SwiftyTheFox001/RelayClock/relayclock_digits.png

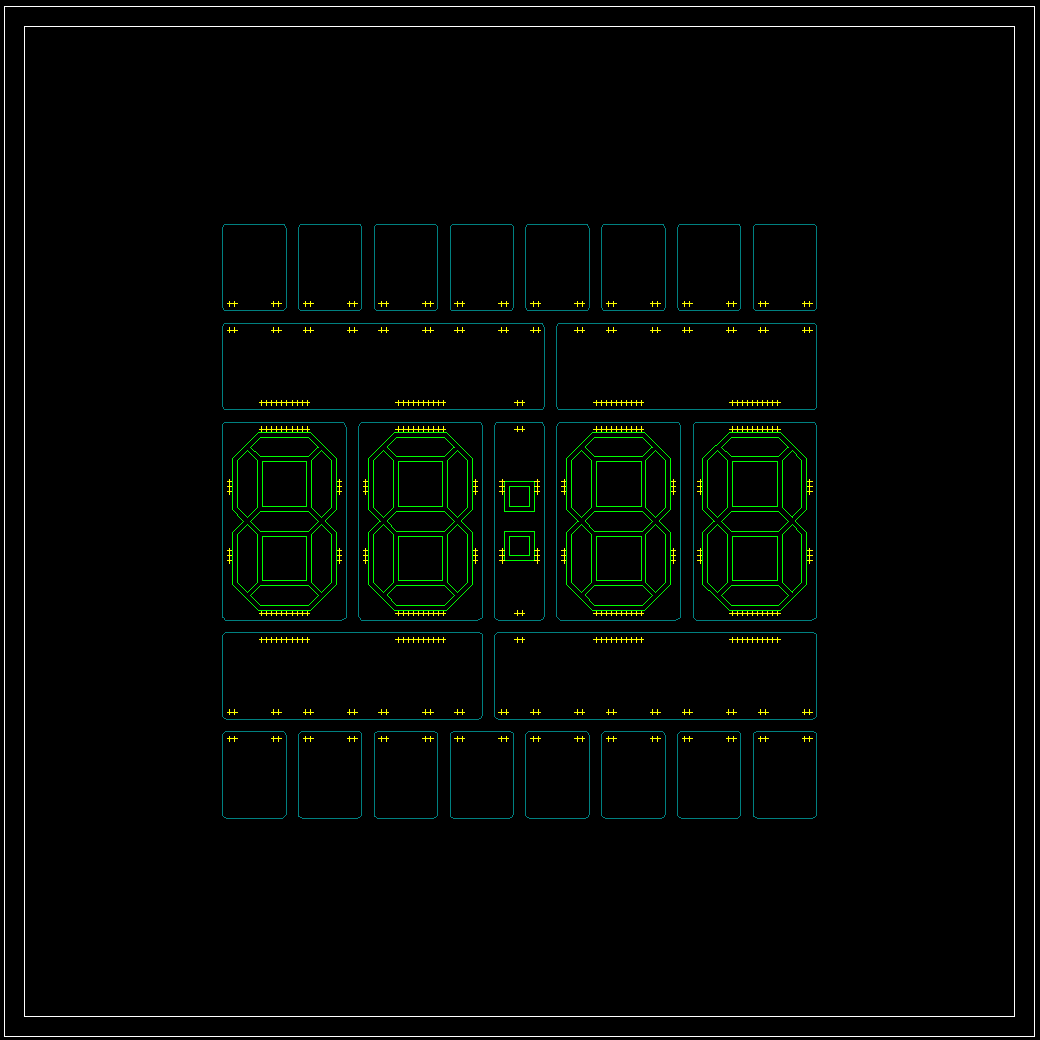
relayclock_digits.png
