SwiftyTheFox001/RelayClock/relayclock_signals.png

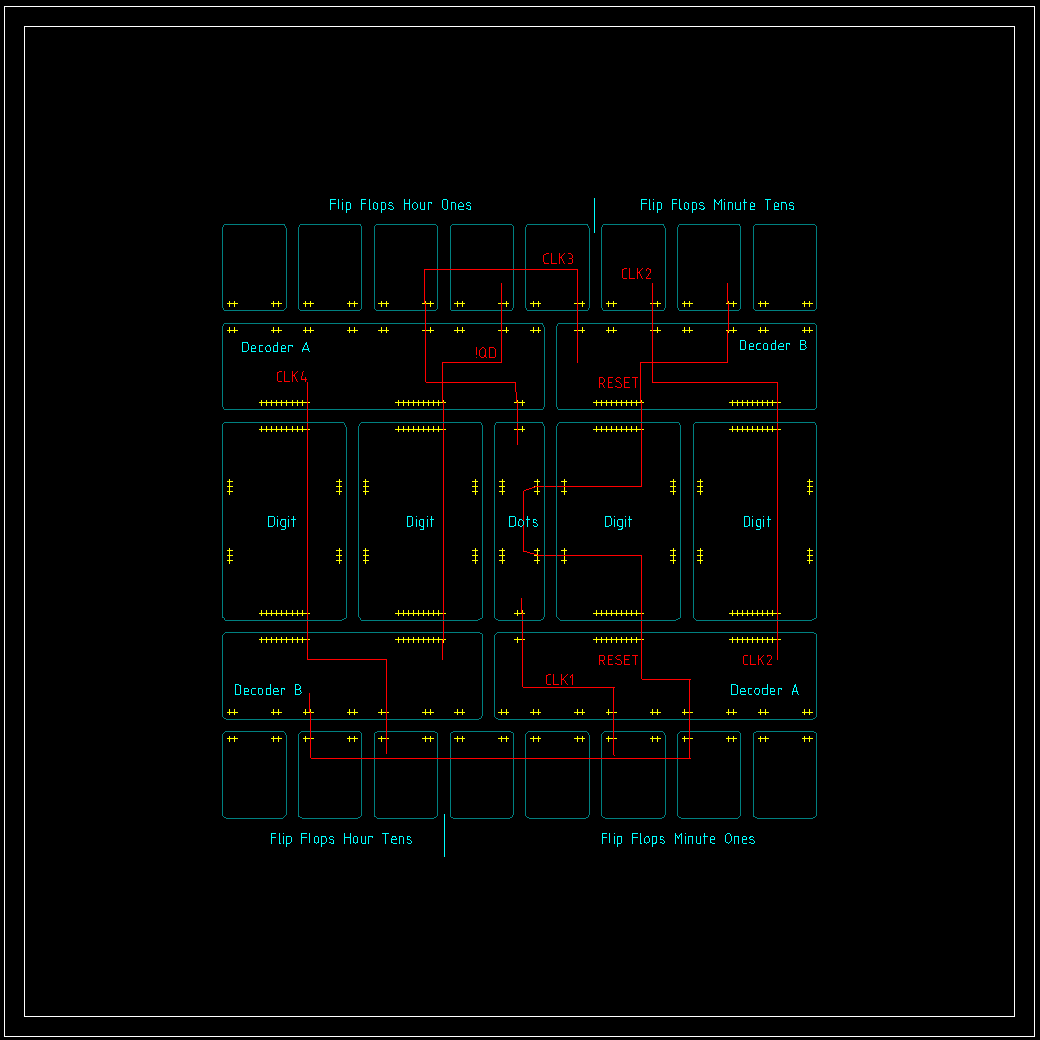
relayclock_signals.png
