SwiftyTheFox001/RelayClock/BOM#.ods

Sheet: Info
 | 16 | 2 | 2 | 4 | 1
Descr. | FlipFlop | Decoder A | Decoder B | Digit | Dot | Sum | Ordered
FTR-B4 | 3 | 7 | 5 | 0 | 4 | 76 | 80
D | 7 | 56 | 32 | 0 | 0 | 288 | 300
LED | 1 | 0 | 0 | 21 | 6 | 106 | 110
33R | 0 | 0 | 0 | 7 | 2 | 30 | 40
100R | 0 | 2 | 2 | 0 | 0 | 8 | 10
220R | 1 | 0 | 0 | 0 | 0 | 16 | 20
Pinheader | 18 | 0 | 0 | 40 | 8 | 456 | 500
Fem.Pinheader | 0 | 40 | 34 | 0 | 0 | 148 | 200
If | 20 | mA
Imax | 560 | mA
POTI calc
R1a | 1800 | Ohm
R1b | 20000 | Ohm
R2 | 2500 | Ohm
Voutmin | 2,15 | V
Voutmax | 12,15 | V
Imin | 0,50 | mA
Imax | 0,50 | mA

Sheet: Flip Flip
Reference | Value | Footprint | Datasheet
R1 | 220R | Resistor_THT:R_Axial_DIN0207_L6.3mm_D2.5mm_P10.16mm_Horizontal
J3 | Conn_01x02 | Connector_PinHeader_2.54mm:PinHeader_1x02_P2.54mm_Vertical
J4 | Conn_01x02 | Connector_PinHeader_2.54mm:PinHeader_1x02_P2.54mm_Vertical
J1 | Conn_01x07 | Connector_PinHeader_2.54mm:PinHeader_1x07_P2.54mm_Vertical
J2 | Conn_01x07 | Connector_PinHeader_2.54mm:PinHeader_1x07_P2.54mm_Vertical
D2 | D | Diode_THT:D_DO-41_SOD81_P2.54mm_Vertical_AnodeUp
D4 | D | Diode_THT:D_DO-41_SOD81_P2.54mm_Vertical_AnodeUp
D7 | D | Diode_THT:D_DO-41_SOD81_P2.54mm_Vertical_AnodeUp
D8 | D | Diode_THT:D_DO-41_SOD81_P2.54mm_Vertical_AnodeUp
D1 | D | Diode_THT:D_DO-41_SOD81_P7.62mm_Horizontal
D5 | D | Diode_THT:D_DO-41_SOD81_P7.62mm_Horizontal
D6 | D | Diode_THT:D_DO-41_SOD81_P7.62mm_Horizontal
JP1 | Jumper | Jumper:SolderJumper_01x02
JP2 | Jumper | Jumper:SolderJumper_01x02
JP3 | Jumper | Jumper:SolderJumper_01x02
JP4 | Jumper | Jumper:SolderJumper_01x02
JP5 | Jumper | Jumper:SolderJumper_01x02
D3 | LED | LED_THT:LED_D3.0mm
K1 | FTR-B4 | relayclock:FTR-B4_PTH
K2 | FTR-B4 | relayclock:FTR-B4_PTH
K3 | FTR-B4 | relayclock:FTR-B4_PTH
R2 | 400R | Resistor_THT:R_Axial_DIN0207_L6.3mm_D2.5mm_P10.16mm_Horizontal
1 | 220R
1 | 400R
1 | LED
3 | FTR-B4
7 | D
18 | Pinheader

Sheet: Decoder A
Reference | Value | Footprint | Datasheet
C1 | CP | Capacitor_THT:C_Rect_L7.0mm_W3.5mm_P2.50mm_P5.00mm
C2 | CP | Capacitor_THT:C_Rect_L7.0mm_W3.5mm_P2.50mm_P5.00mm
D1 | D | Diode_THT:D_DO-41_SOD81_P7.62mm_Horizontal
D10 | D | Diode_THT:D_DO-41_SOD81_P7.62mm_Horizontal
D11 | D | Diode_THT:D_DO-41_SOD81_P7.62mm_Horizontal
D12 | D | Diode_THT:D_DO-41_SOD81_P7.62mm_Horizontal
D13 | D | Diode_THT:D_DO-41_SOD81_P7.62mm_Horizontal
D14 | D | Diode_THT:D_DO-41_SOD81_P7.62mm_Horizontal
D15 | D | Diode_THT:D_DO-41_SOD81_P7.62mm_Horizontal
D16 | D | Diode_THT:D_DO-41_SOD81_P7.62mm_Horizontal
D17 | D | Diode_THT:D_DO-41_SOD81_P7.62mm_Horizontal
D18 | D | Diode_THT:D_DO-41_SOD81_P7.62mm_Horizontal
D19 | D | Diode_THT:D_DO-41_SOD81_P7.62mm_Horizontal
D2 | D | Diode_THT:D_DO-41_SOD81_P7.62mm_Horizontal
D20 | D | Diode_THT:D_DO-41_SOD81_P7.62mm_Horizontal
D21 | D | Diode_THT:D_DO-41_SOD81_P7.62mm_Horizontal
D22 | D | Diode_THT:D_DO-41_SOD81_P7.62mm_Horizontal
D23 | D | Diode_THT:D_DO-41_SOD81_P7.62mm_Horizontal
D24 | D | Diode_THT:D_DO-41_SOD81_P7.62mm_Horizontal
D25 | D | Diode_THT:D_DO-41_SOD81_P7.62mm_Horizontal
D26 | D | Diode_THT:D_DO-41_SOD81_P7.62mm_Horizontal
D27 | D | Diode_THT:D_DO-41_SOD81_P7.62mm_Horizontal
D28 | D | Diode_THT:D_DO-41_SOD81_P7.62mm_Horizontal
D29 | D | Diode_THT:D_DO-41_SOD81_P7.62mm_Horizontal
D3 | D | Diode_THT:D_DO-41_SOD81_P7.62mm_Horizontal
D30 | D | Diode_THT:D_DO-41_SOD81_P7.62mm_Horizontal
D31 | D | Diode_THT:D_DO-41_SOD81_P7.62mm_Horizontal
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
K6 | FTR-B4 | relayclock:FTR-B4_PTH
K7 | FTR-B4 | relayclock:FTR-B4_PTH
R1 | 100R | Resistor_THT:R_Axial_DIN0207_L6.3mm_D2.5mm_P10.16mm_Horizontal
R2 | 100R | Resistor_THT:R_Axial_DIN0207_L6.3mm_D2.5mm_P10.16mm_Horizontal
2 | 100R
7 | FTR-B4
56 | D
40 | Fem. Pinheader

Sheet: Decoder B
Reference | Value | Footprint | Datasheet
C1 | CP | Capacitor_THT:C_Rect_L7.0mm_W3.5mm_P2.50mm_P5.00mm
C2 | CP | Capacitor_THT:C_Rect_L7.0mm_W3.5mm_P2.50mm_P5.00mm
D1 | D | Diode_THT:D_DO-41_SOD81_P7.62mm_Horizontal
D2 | D | Diode_THT:D_DO-41_SOD81_P7.62mm_Horizontal
D10 | D | Diode_THT:D_DO-41_SOD81_P7.62mm_Horizontal
D11 | D | Diode_THT:D_DO-41_SOD81_P7.62mm_Horizontal
D12 | D | Diode_THT:D_DO-41_SOD81_P7.62mm_Horizontal
D13 | D | Diode_THT:D_DO-41_SOD81_P7.62mm_Horizontal
D14 | D | Diode_THT:D_DO-41_SOD81_P7.62mm_Horizontal
D15 | D | Diode_THT:D_DO-41_SOD81_P7.62mm_Horizontal
D16 | D | Diode_THT:D_DO-41_SOD81_P7.62mm_Horizontal
D17 | D | Diode_THT:D_DO-41_SOD81_P7.62mm_Horizontal
D18 | D | Diode_THT:D_DO-41_SOD81_P7.62mm_Horizontal
D19 | D | Diode_THT:D_DO-41_SOD81_P7.62mm_Horizontal
D20 | D | Diode_THT:D_DO-41_SOD81_P7.62mm_Horizontal
D21 | D | Diode_THT:D_DO-41_SOD81_P7.62mm_Horizontal
D22 | D | Diode_THT:D_DO-41_SOD81_P7.62mm_Horizontal
D23 | D | Diode_THT:D_DO-41_SOD81_P7.62mm_Horizontal
D24 | D | Diode_THT:D_DO-41_SOD81_P7.62mm_Horizontal
D25 | D | Diode_THT:D_DO-41_SOD81_P7.62mm_Horizontal
D26 | D | Diode_THT:D_DO-41_SOD81_P7.62mm_Horizontal
D27 | D | Diode_THT:D_DO-41_SOD81_P7.62mm_Horizontal
D28 | D | Diode_THT:D_DO-41_SOD81_P7.62mm_Horizontal
D29 | D | Diode_THT:D_DO-41_SOD81_P7.62mm_Horizontal
D3 | D | Diode_THT:D_DO-41_SOD81_P7.62mm_Horizontal
D30 | D | Diode_THT:D_DO-41_SOD81_P7.62mm_Horizontal
D31 | D | Diode_THT:D_DO-41_SOD81_P7.62mm_Horizontal
D32 | D | Diode_THT:D_DO-41_SOD81_P7.62mm_Horizontal
D4 | D | Diode_THT:D_DO-41_SOD81_P7.62mm_Horizontal
D5 | D | Diode_THT:D_DO-41_SOD81_P7.62mm_Horizontal
D6 | D | Diode_THT:D_DO-41_SOD81_P7.62mm_Horizontal
D7 | D | Diode_THT:D_DO-41_SOD81_P7.62mm_Horizontal
D8 | D | Diode_THT:D_DO-41_SOD81_P7.62mm_Horizontal
D9 | D | Diode_THT:D_DO-41_SOD81_P7.62mm_Horizontal
J1 | Conn_01x02 | Connector_PinHeader_2.54mm:PinHeader_1x02_P2.54mm_Vertical
J2 | Conn_01x02 | Connector_PinHeader_2.54mm:PinHeader_1x02_P2.54mm_Vertical
J3 | Conn_01x02 | Connector_PinHeader_2.54mm:PinHeader_1x02_P2.54mm_Vertical
J4 | Conn_01x02 | Connector_PinHeader_2.54mm:PinHeader_1x02_P2.54mm_Vertical
J5 | Conn_01x02 | Connector_PinHeader_2.54mm:PinHeader_1x02_P2.54mm_Vertical
J6 | Conn_01x02 | Connector_PinHeader_2.54mm:PinHeader_1x02_P2.54mm_Vertical
J7 | Conn_01x02 | Connector_PinHeader_2.54mm:PinHeader_1x02_P2.54mm_Vertical
J8 | Conn_01x10 | Connector_PinHeader_2.54mm:PinHeader_1x10_P2.54mm_Vertical
J9 | Conn_01x10 | Connector_PinHeader_2.54mm:PinHeader_1x10_P2.54mm_Vertical
JP1 | Jumper | Jumper:SolderJumper_01x02
JP2 | Jumper | Jumper:SolderJumper_01x02
JP3 | Jumper | Jumper:SolderJumper_01x02
JP4 | Jumper | Jumper:SolderJumper_01x02
JP5 | Jumper | Jumper:SolderJumper_01x02
JP6 | Jumper | Jumper:SolderJumper_01x02
JP7 | Jumper | Jumper:SolderJumper_01x02
JP8 | Jumper | Jumper:SolderJumper_01x02
JP9 | Jumper | Jumper:SolderJumper_01x02
K1 | FTR-B4 | relayclock:FTR-B4_PTH
K2 | FTR-B4 | relayclock:FTR-B4_PTH
K3 | FTR-B4 | relayclock:FTR-B4_PTH
K4 | FTR-B4 | relayclock:FTR-B4_PTH
K5 | FTR-B4 | relayclock:FTR-B4_PTH
R1 | 100R | Resistor_THT:R_Axial_DIN0207_L6.3mm_D2.5mm_P10.16mm_Horizontal
R2 | 100R | Resistor_THT:R_Axial_DIN0207_L6.3mm_D2.5mm_P10.16mm_Horizontal
2 | 100R
5 | FTR-B4
32 | D
34 | Fem. Pinheader

Sheet: Digit
Reference | Value | Footprint | Datasheet
J1 | Conn_01x10 | Connector_PinHeader_2.54mm:PinHeader_1x10_P2.54mm_Vertical
D1 | LED | Diode_SMD:D_0805_2012Metric_Pad0.97x1.50mm_HandSolder
D10 | LED | Diode_SMD:D_0805_2012Metric_Pad0.97x1.50mm_HandSolder
D11 | LED | Diode_SMD:D_0805_2012Metric_Pad0.97x1.50mm_HandSolder
D12 | LED | Diode_SMD:D_0805_2012Metric_Pad0.97x1.50mm_HandSolder
D13 | LED | Diode_SMD:D_0805_2012Metric_Pad0.97x1.50mm_HandSolder
D14 | LED | Diode_SMD:D_0805_2012Metric_Pad0.97x1.50mm_HandSolder
D15 | LED | Diode_SMD:D_0805_2012Metric_Pad0.97x1.50mm_HandSolder
D16 | LED | Diode_SMD:D_0805_2012Metric_Pad0.97x1.50mm_HandSolder
D17 | LED | Diode_SMD:D_0805_2012Metric_Pad0.97x1.50mm_HandSolder
D18 | LED | Diode_SMD:D_0805_2012Metric_Pad0.97x1.50mm_HandSolder
D19 | LED | Diode_SMD:D_0805_2012Metric_Pad0.97x1.50mm_HandSolder
D2 | LED | Diode_SMD:D_0805_2012Metric_Pad0.97x1.50mm_HandSolder
D20 | LED | Diode_SMD:D_0805_2012Metric_Pad0.97x1.50mm_HandSolder
D21 | LED | Diode_SMD:D_0805_2012Metric_Pad0.97x1.50mm_HandSolder
D3 | LED | Diode_SMD:D_0805_2012Metric_Pad0.97x1.50mm_HandSolder
D4 | LED | Diode_SMD:D_0805_2012Metric_Pad0.97x1.50mm_HandSolder
D5 | LED | Diode_SMD:D_0805_2012Metric_Pad0.97x1.50mm_HandSolder
D6 | LED | Diode_SMD:D_0805_2012Metric_Pad0.97x1.50mm_HandSolder
D7 | LED | Diode_SMD:D_0805_2012Metric_Pad0.97x1.50mm_HandSolder
D8 | LED | Diode_SMD:D_0805_2012Metric_Pad0.97x1.50mm_HandSolder
D9 | LED | Diode_SMD:D_0805_2012Metric_Pad0.97x1.50mm_HandSolder
J2 | Conn_01x10 | Connector_PinHeader_2.54mm:PinHeader_1x10_P2.54mm_Vertical
J3 | Conn_01x10 | Connector_PinHeader_2.54mm:PinHeader_1x10_P2.54mm_Vertical
J4 | Conn_01x10 | Connector_PinHeader_2.54mm:PinHeader_1x10_P2.54mm_Vertical
R1 | 33R | Resistor_THT:R_Axial_DIN0207_L6.3mm_D2.5mm_P10.16mm_Horizontal
R2 | 33R | Resistor_THT:R_Axial_DIN0207_L6.3mm_D2.5mm_P10.16mm_Horizontal
R3 | 33R | Resistor_THT:R_Axial_DIN0207_L6.3mm_D2.5mm_P10.16mm_Horizontal
R4 | 33R | Resistor_THT:R_Axial_DIN0207_L6.3mm_D2.5mm_P10.16mm_Horizontal
R5 | 33R | Resistor_THT:R_Axial_DIN0207_L6.3mm_D2.5mm_P10.16mm_Horizontal
R6 | 33R | Resistor_THT:R_Axial_DIN0207_L6.3mm_D2.5mm_P10.16mm_Horizontal
R7 | 33R | Resistor_THT:R_Axial_DIN0207_L6.3mm_D2.5mm_P10.16mm_Horizontal
7 | 33R
0 | FTR-B4
21 | LED
40 | Pinheader

Sheet: DOT
Reference | Value | Footprint | Datasheet
R2 | 2k5 | Resistor_THT:R_Axial_DIN0207_L6.3mm_D2.5mm_P10.16mm_Horizontal
C1 | 10u | Capacitor_THT:C_Rect_L7.0mm_W3.5mm_P2.50mm_P5.00mm
C2 | 100u | Capacitor_THT:C_Rect_L7.0mm_W3.5mm_P2.50mm_P5.00mm
D1 | LED | LED_SMD:LED_0805_2012Metric_Pad0.97x1.50mm_HandSolder
D2 | LED | LED_SMD:LED_0805_2012Metric_Pad0.97x1.50mm_HandSolder
D3 | LED | LED_SMD:LED_0805_2012Metric_Pad0.97x1.50mm_HandSolder
D4 | LED | LED_SMD:LED_0805_2012Metric_Pad0.97x1.50mm_HandSolder
D5 | LED | LED_SMD:LED_0805_2012Metric_Pad0.97x1.50mm_HandSolder
D6 | LED | LED_SMD:LED_0805_2012Metric_Pad0.97x1.50mm_HandSolder
J1 | Conn_01x02 | Connector_PinHeader_2.54mm:PinHeader_1x02_P2.54mm_Vertical
J2 | Conn_01x02 | Connector_PinHeader_2.54mm:PinHeader_1x02_P2.54mm_Vertical
J3 | Conn_01x02 | Connector_PinHeader_2.54mm:PinHeader_1x02_P2.54mm_Vertical
J4 | Conn_01x02 | Connector_PinHeader_2.54mm:PinHeader_1x02_P2.54mm_Vertical
K1 | FTR-B4 | relayclock:FTR-B4_PTH
K2 | FTR-B4 | relayclock:FTR-B4_PTH
K3 | FTR-B4 | relayclock:FTR-B4_PTH
K4 | FTR-B4 | relayclock:FTR-B4_PTH
Q1 | Q_NMOS_GSD | Package_TO_SOT_SMD:SOT-23
Q2 | Q_NMOS_GSD | Package_TO_SOT_SMD:SOT-23
Q3 | Q_NMOS_GSD | Package_TO_SOT_SMD:SOT-23
Q4 | Q_NMOS_GSD | Package_TO_SOT_SMD:SOT-23
Q5 | Q_NMOS_DSG | Package_TO_SOT_SMD:SOT-23
Q6 | Q_NMOS_DSG | Package_TO_SOT_SMD:SOT-23
R1 | 1k8 | Resistor_THT:R_Axial_DIN0207_L6.3mm_D2.5mm_P10.16mm_Horizontal
RV1 | 20k
SW1 | SW_Push | Button_Switch_THT:SW_PUSH_6mm
SW2 | SW_Push | Button_Switch_THT:SW_PUSH_6mm
U1 | AP1117-ADJ | TO_SOT_Packages_SMD:SOT-223-3_TabPin2
2 | 33R
4 | FTR-B4
6 | LED
8 | Pinheader
