SwiftyTheFox001/RelayClock/relayclock.dxf

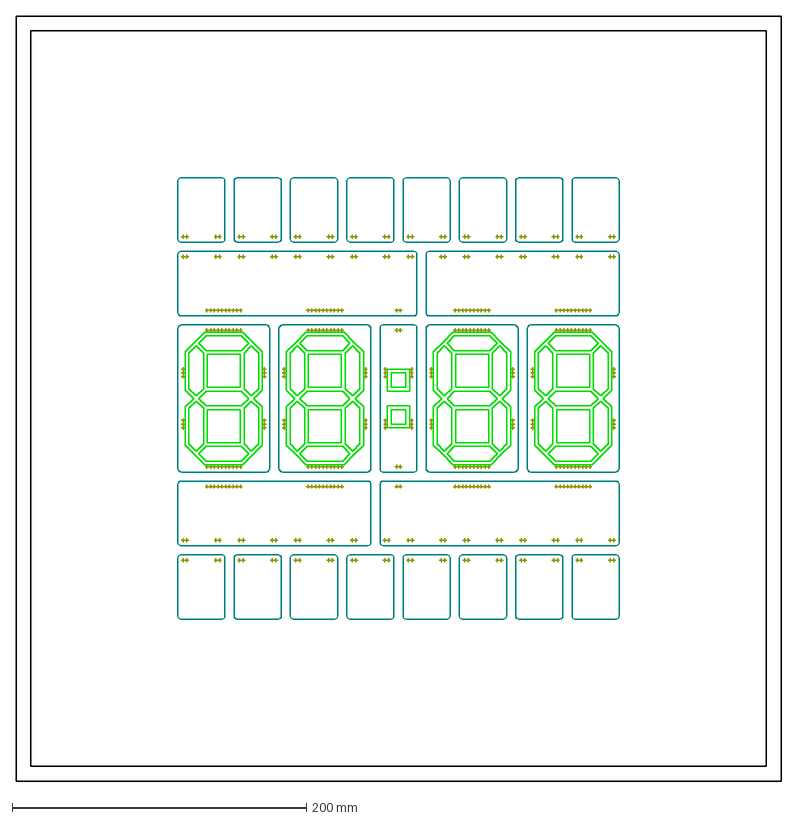
[picture p3: CAD file, 2018-02-17]
relayclock.dxf
520.0 x 520.0 mm
