SwiftyTheFox001/RelayClock/kicad/Dots/Dots.kicad_pcb

## KiCad design kicad/Dots/Dots.kicad_pcb (2018-02-17)

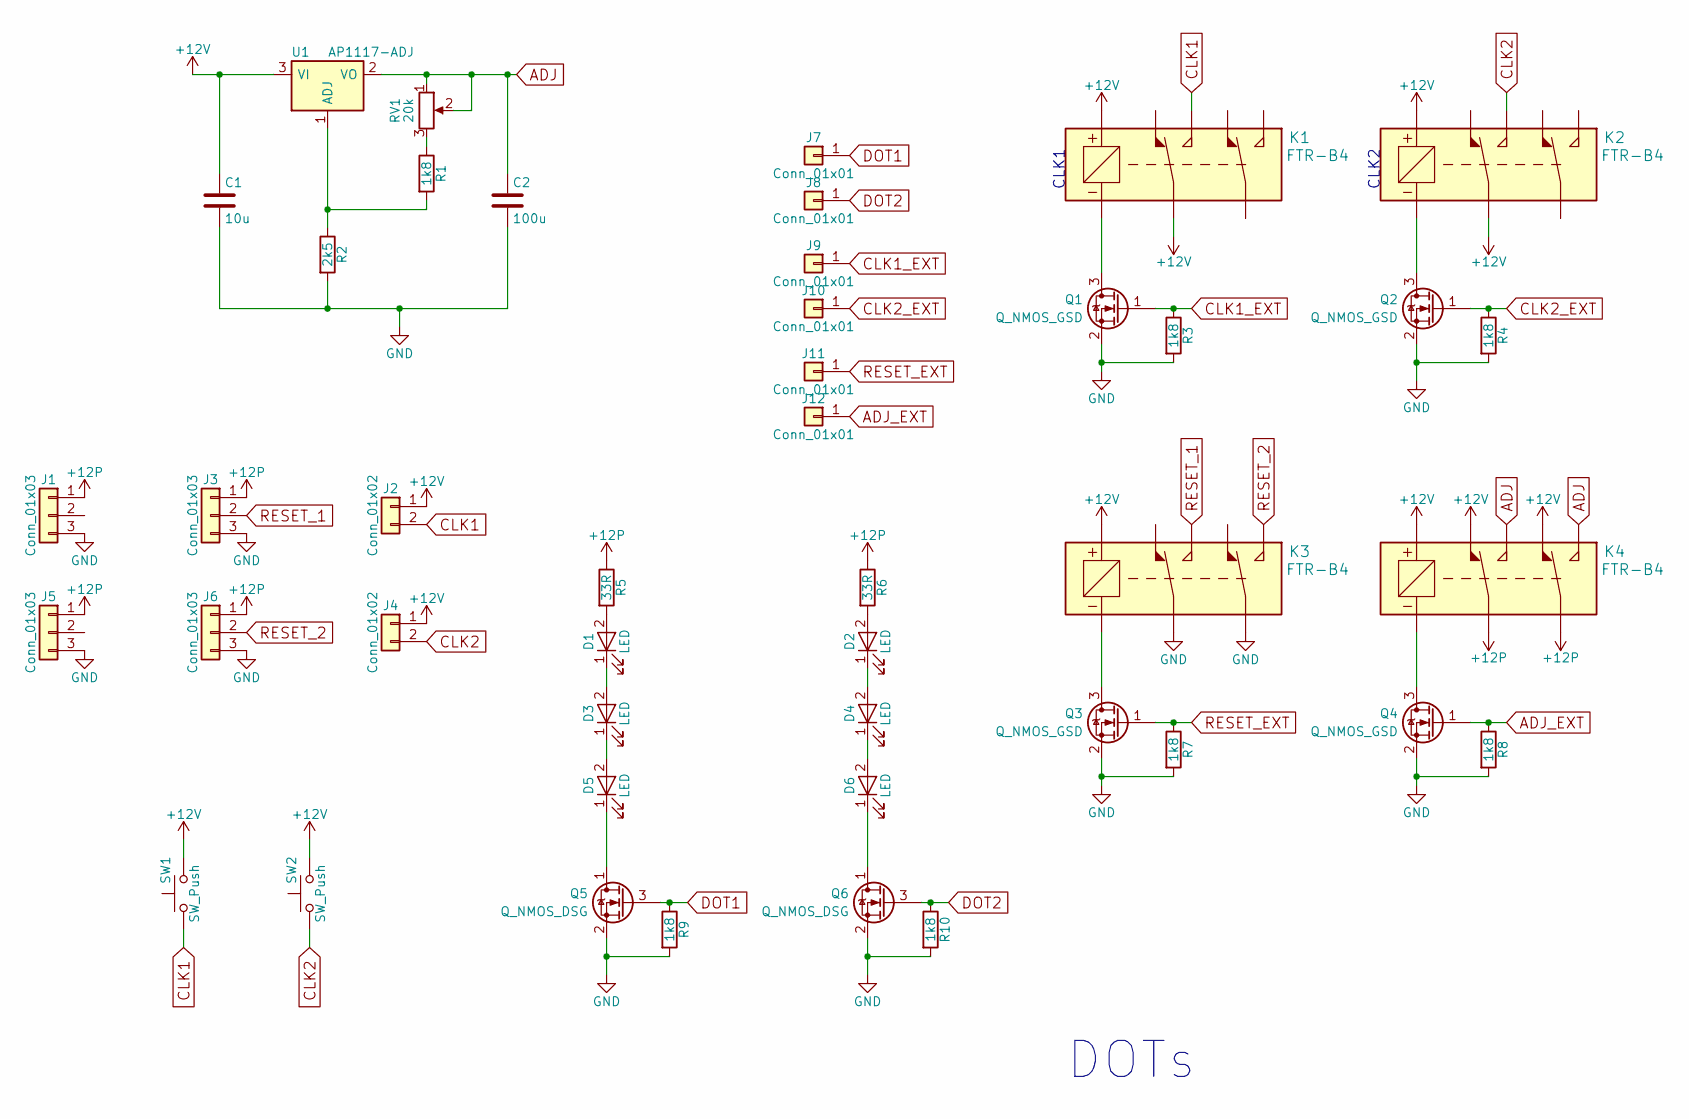
[picture p4: schematic Dots.sch]

Parts:
C1: 10u; C_Rect_L7.0mm_W3.5mm_P2.50mm_P5.00mm
C2: 100u; C_Rect_L7.0mm_W3.5mm_P2.50mm_P5.00mm
D1, D2, D3, D4, D5, D6: LED; LED_0805_2012Metric_Pad0.97x1.50mm_HandSolder
J1, J3, J5, J6: Conn_01x03; PinHeader_1x03_P2.54mm_Vertical
J2, J4: Conn_01x02; PinHeader_1x02_P2.54mm_Vertical
J7, J8, J9, J10, J11, J12: Conn_01x01; TestPoint_Pad_3.0x3.0mm
K1, K2, K3, K4: FTR-B4; FTR-B4_PTH
Q1, Q2, Q3, Q4: Q_NMOS_GSD; SOT-23
Q5, Q6: Q_NMOS_DSG; SOT-23
R1, R3, R4, R7, R8, R9, R10: 1k8; R_Axial_DIN0207_L6.3mm_D2.5mm_P10.16mm_Horizontal
R2: 2k5; R_Axial_DIN0207_L6.3mm_D2.5mm_P10.16mm_Horizontal
R5, R6: 33R; R_Axial_DIN0207_L6.3mm_D2.5mm_P10.16mm_Horizontal
RV1: 20k; TrimmPoti_Model23A_SMD
SW1, SW2: SW_Push; SW_PUSH_6mm
U1: AP1117-ADJ; SOT-223-3_TabPin2

Connections:
+12P: J1.1, J3.1, J5.1, J6.1, K4.3 (B2), K4.6 (A2), R5.1, R6.1
+12V: C1.1, J2.1, J4.1, K1.1 (+), K1.6 (A2), K2.1 (+), K2.6 (A2), K3.1 (+), K4.1 (+), K4.2 (B1), K4.7 (A1), SW1.2, SW2.2, U1.3 (VI)
ADJ: C2.1, K4.4 (B3), K4.5 (A3), RV1.1, RV1.2, U1.2 (VO)
ADJ_EXT: J12.1, Q4.1 (G), R8.1
CLK1: J2.2, K1.5 (A3), SW1.1
CLK1_EXT: J9.1, Q1.1 (G), R3.1
CLK2: J4.2, K2.5 (A3), SW2.1
CLK2_EXT: J10.1, Q2.1 (G), R4.1
DOT1: J7.1, Q5.3 (G), R9.1
DOT2: J8.1, Q6.3 (G), R10.1
GND: C1.2, C2.2, J1.3, J3.3, J5.3, J6.3, K3.3 (B2), K3.6 (A2), Q1.2 (S), Q2.2 (S), Q3.2 (S), Q4.2 (S), Q5.2 (S), Q6.2 (S), R2.2, R3.2, R4.2, R7.2, R8.2, R9.2, R10.2
unnamed: D1.1 (K), D3.2 (A)
unnamed: D1.2 (A), R5.2
unnamed: D2.1 (K), D4.2 (A)
unnamed: D2.2 (A), R6.2
unnamed: D3.1 (K), D5.2 (A)
unnamed: D4.1 (K), D6.2 (A)
unnamed: D5.1 (K), Q5.1 (D)
unnamed: D6.1 (K), Q6.1 (D)
unnamed: K1.8 (-), Q1.3 (D)
unnamed: K2.8 (-), Q2.3 (D)
unnamed: K3.8 (-), Q3.3 (D)
unnamed: K4.8 (-), Q4.3 (D)
unnamed: R1.1, RV1.3
unnamed: R1.2, R2.1, U1.1 (ADJ)
RESET_1: J3.2, K3.5 (A3)
RESET_2: J6.2, K3.4 (B3)
RESET_EXT: J11.1, Q3.1 (G), R7.1

Notes on the sheet:
CLK1
CLK2
DOTs

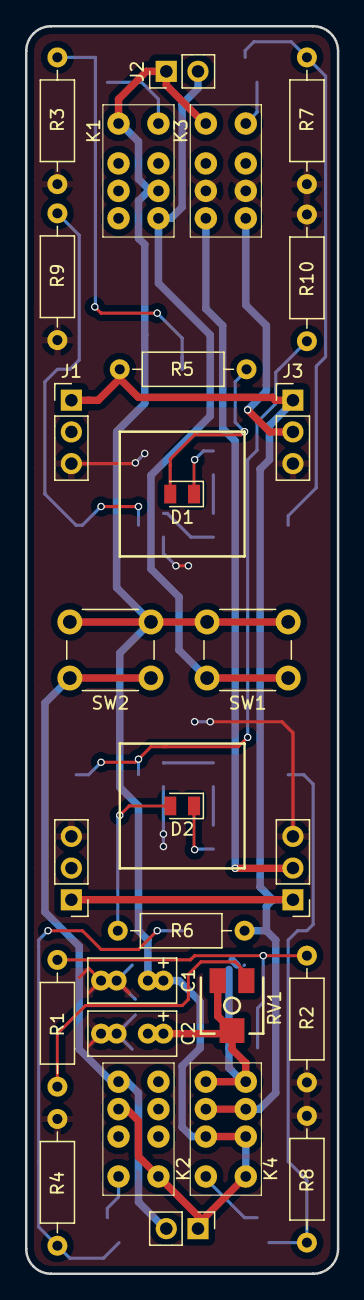
[picture p5: board Dots.kicad_pcb from above]

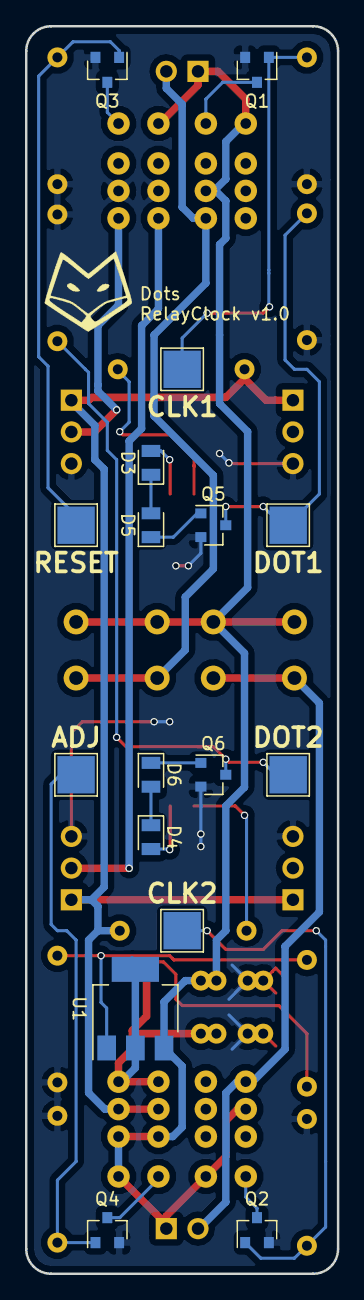
[picture p6: board Dots.kicad_pcb from below]

Board: 2 copper layers, 25.0 x 100.0 mm, 44 parts (17 on the bottom side), 28 nets.
