SwiftyTheFox001/RelayClock/kicad/Digit/Digit.kicad_pcb

## KiCad design kicad/Digit/Digit.kicad_pcb (2018-02-17)

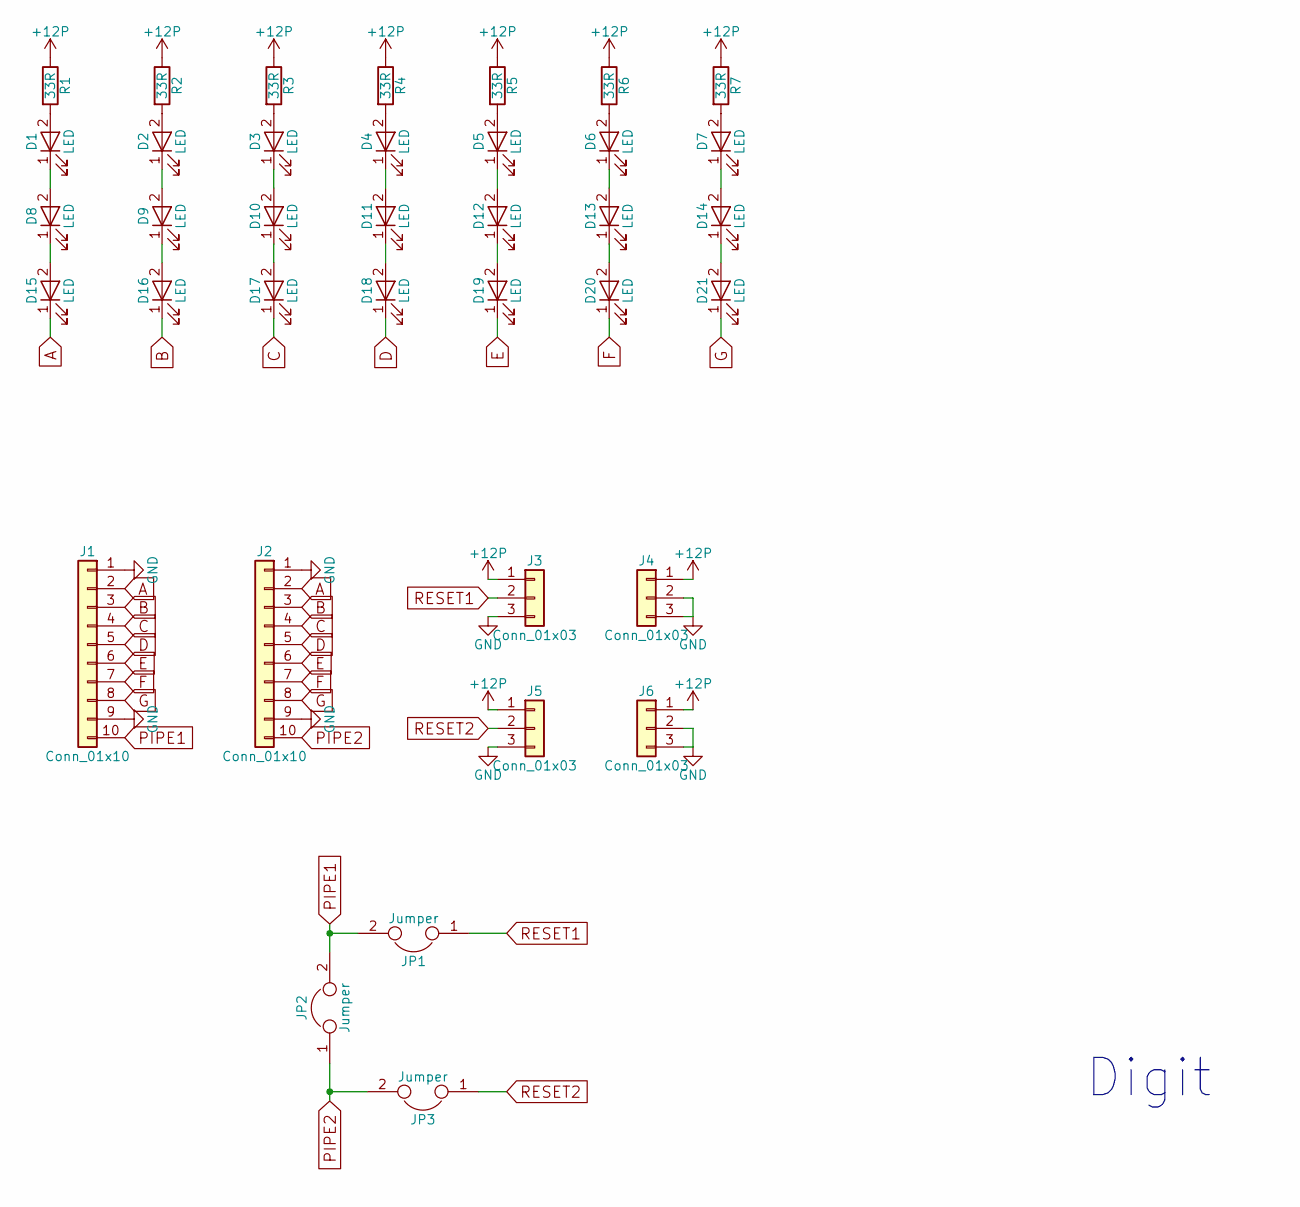
[picture p7: schematic Digit.sch]

Parts:
D1, D2, D3, D4, D5, D6, D7, D8, D9, D10, D11, D12, D13, D14, D15, D16, D17, D18, D19, D20, D21: LED; D_0805_2012Metric_Pad0.97x1.50mm_HandSolder
J1, J2: Conn_01x10; PinHeader_1x10_P2.54mm_Vertical
J3, J4, J5, J6: Conn_01x03; PinHeader_1x03_P2.54mm_Vertical
JP1, JP2, JP3: Jumper; SolderJumper_01x02
R1, R2, R3, R4, R5, R6, R7: 33R; R_Axial_DIN0207_L6.3mm_D2.5mm_P10.16mm_Horizontal

Connections:
+12P: J3.1, J4.1, J5.1, J6.1, R1.1, R2.1, R3.1, R4.1, R5.1, R6.1, R7.1
A: D15.1 (K), J1.2, J2.2
B: D16.1 (K), J1.3, J2.3
C: D17.1 (K), J1.4, J2.4
D: D18.1 (K), J1.5, J2.5
E: D19.1 (K), J1.6, J2.6
F: D20.1 (K), J1.7, J2.7
G: D21.1 (K), J1.8, J2.8
GND: J1.1, J1.9, J2.1, J2.9, J3.3, J4.2, J4.3, J5.3, J6.2, J6.3
unnamed: D1.1 (K), D8.2 (A)
unnamed: D1.2 (A), R1.2
unnamed: D2.1 (K), D9.2 (A)
unnamed: D2.2 (A), R2.2
unnamed: D3.2 (A), R3.2
unnamed: D4.2 (A), R4.2
unnamed: D5.2 (A), R5.2
unnamed: D6.2 (A), R6.2
unnamed: D7.2 (A), R7.2
unnamed: D10.1 (K), D17.2 (A)
unnamed: D3.1 (K), D10.2 (A)
unnamed: D11.1 (K), D18.2 (A)
unnamed: D4.1 (K), D11.2 (A)
unnamed: D12.1 (K), D19.2 (A)
unnamed: D5.1 (K), D12.2 (A)
unnamed: D13.1 (K), D20.2 (A)
unnamed: D6.1 (K), D13.2 (A)
unnamed: D14.1 (K), D21.2 (A)
unnamed: D7.1 (K), D14.2 (A)
unnamed: D8.1 (K), D15.2 (A)
unnamed: D9.1 (K), D16.2 (A)
PIPE1: J1.10, JP1.2, JP2.2
PIPE2: J2.10, JP2.1, JP3.2
RESET1: J3.2, JP1.1
RESET2: J5.2, JP3.1

Notes on the sheet:
Digit

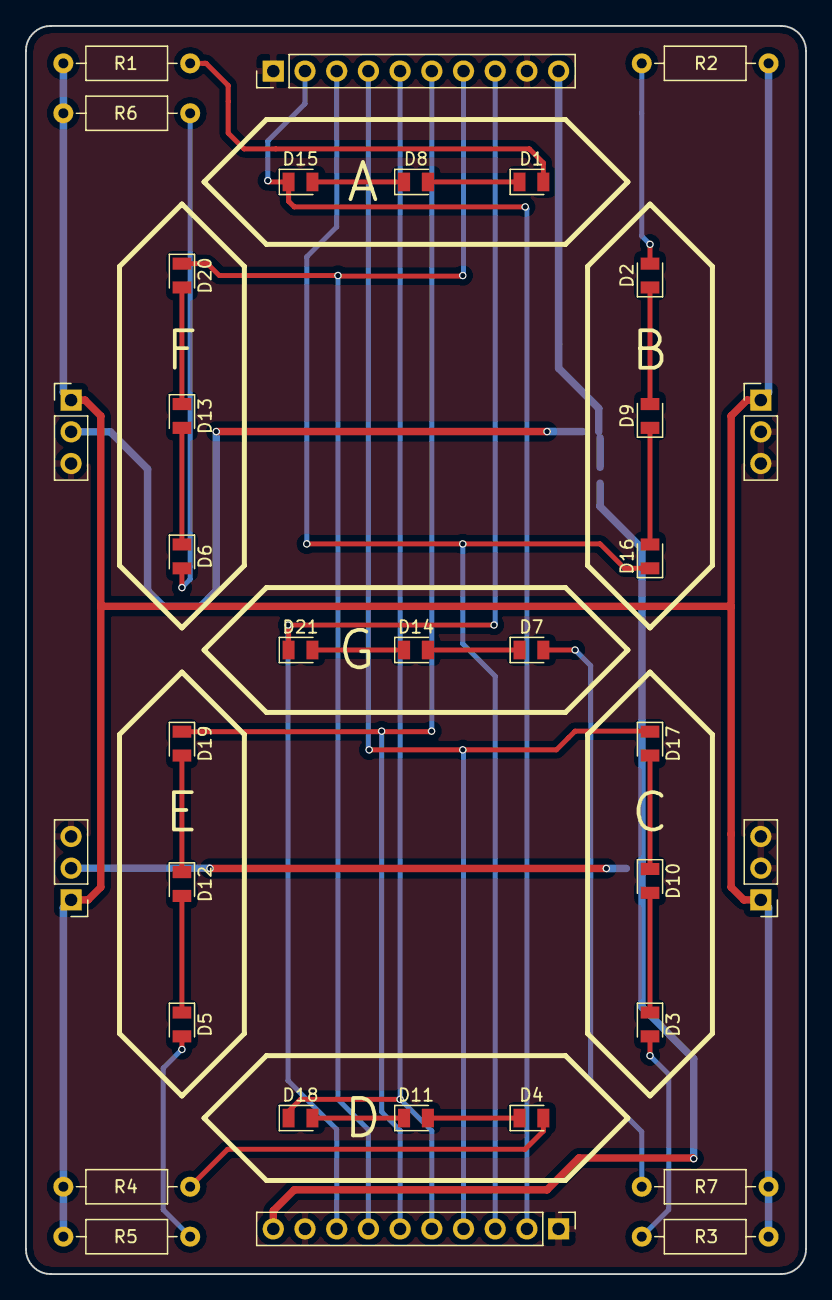
[picture p8: board Digit.kicad_pcb from above]

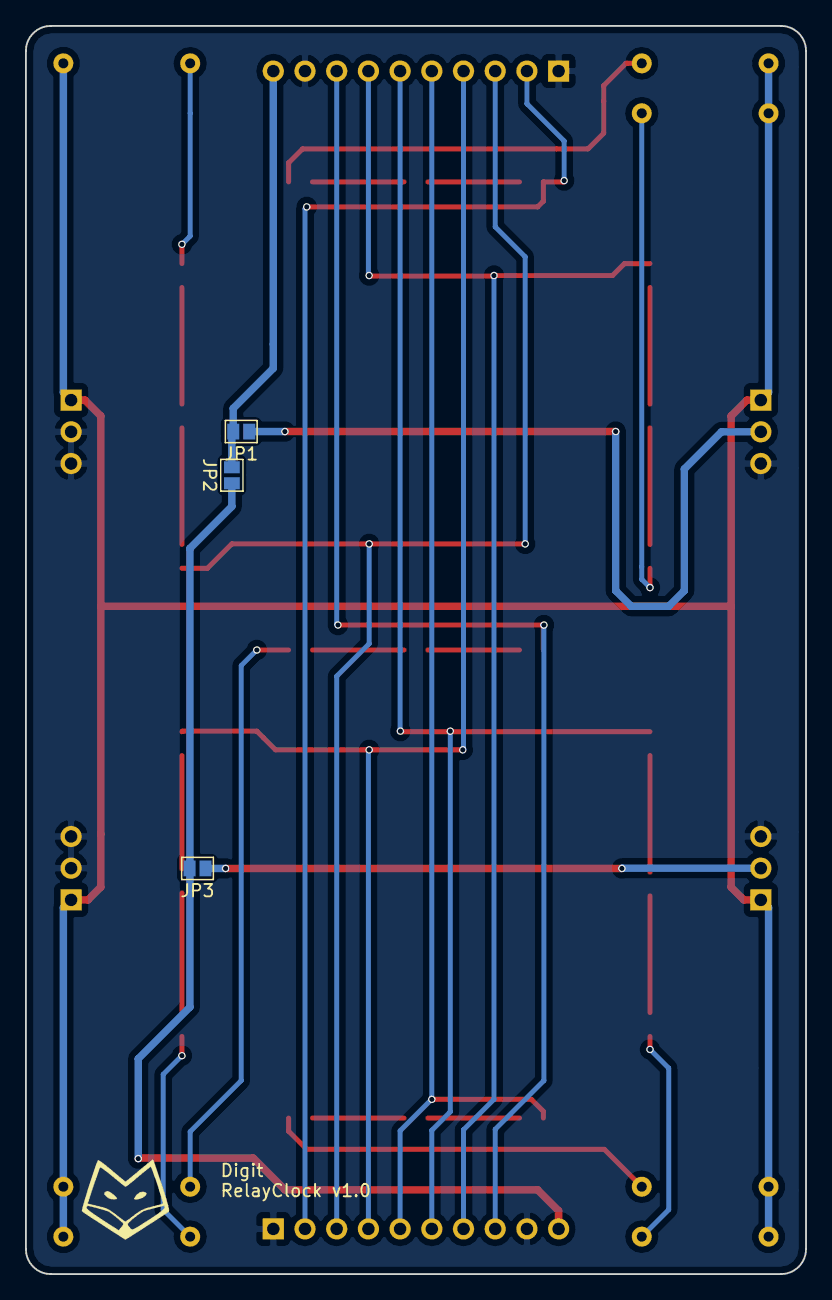
[picture p9: board Digit.kicad_pcb from below]

Board: 2 copper layers, 62.5 x 100.0 mm, 37 parts (3 on the bottom side), 34 nets.
