SwiftyTheFox001/RelayClock/kicad/DecoderA/DecoderA.kicad_pcb

## KiCad design kicad/DecoderA/DecoderA.kicad_pcb (2018-02-17)

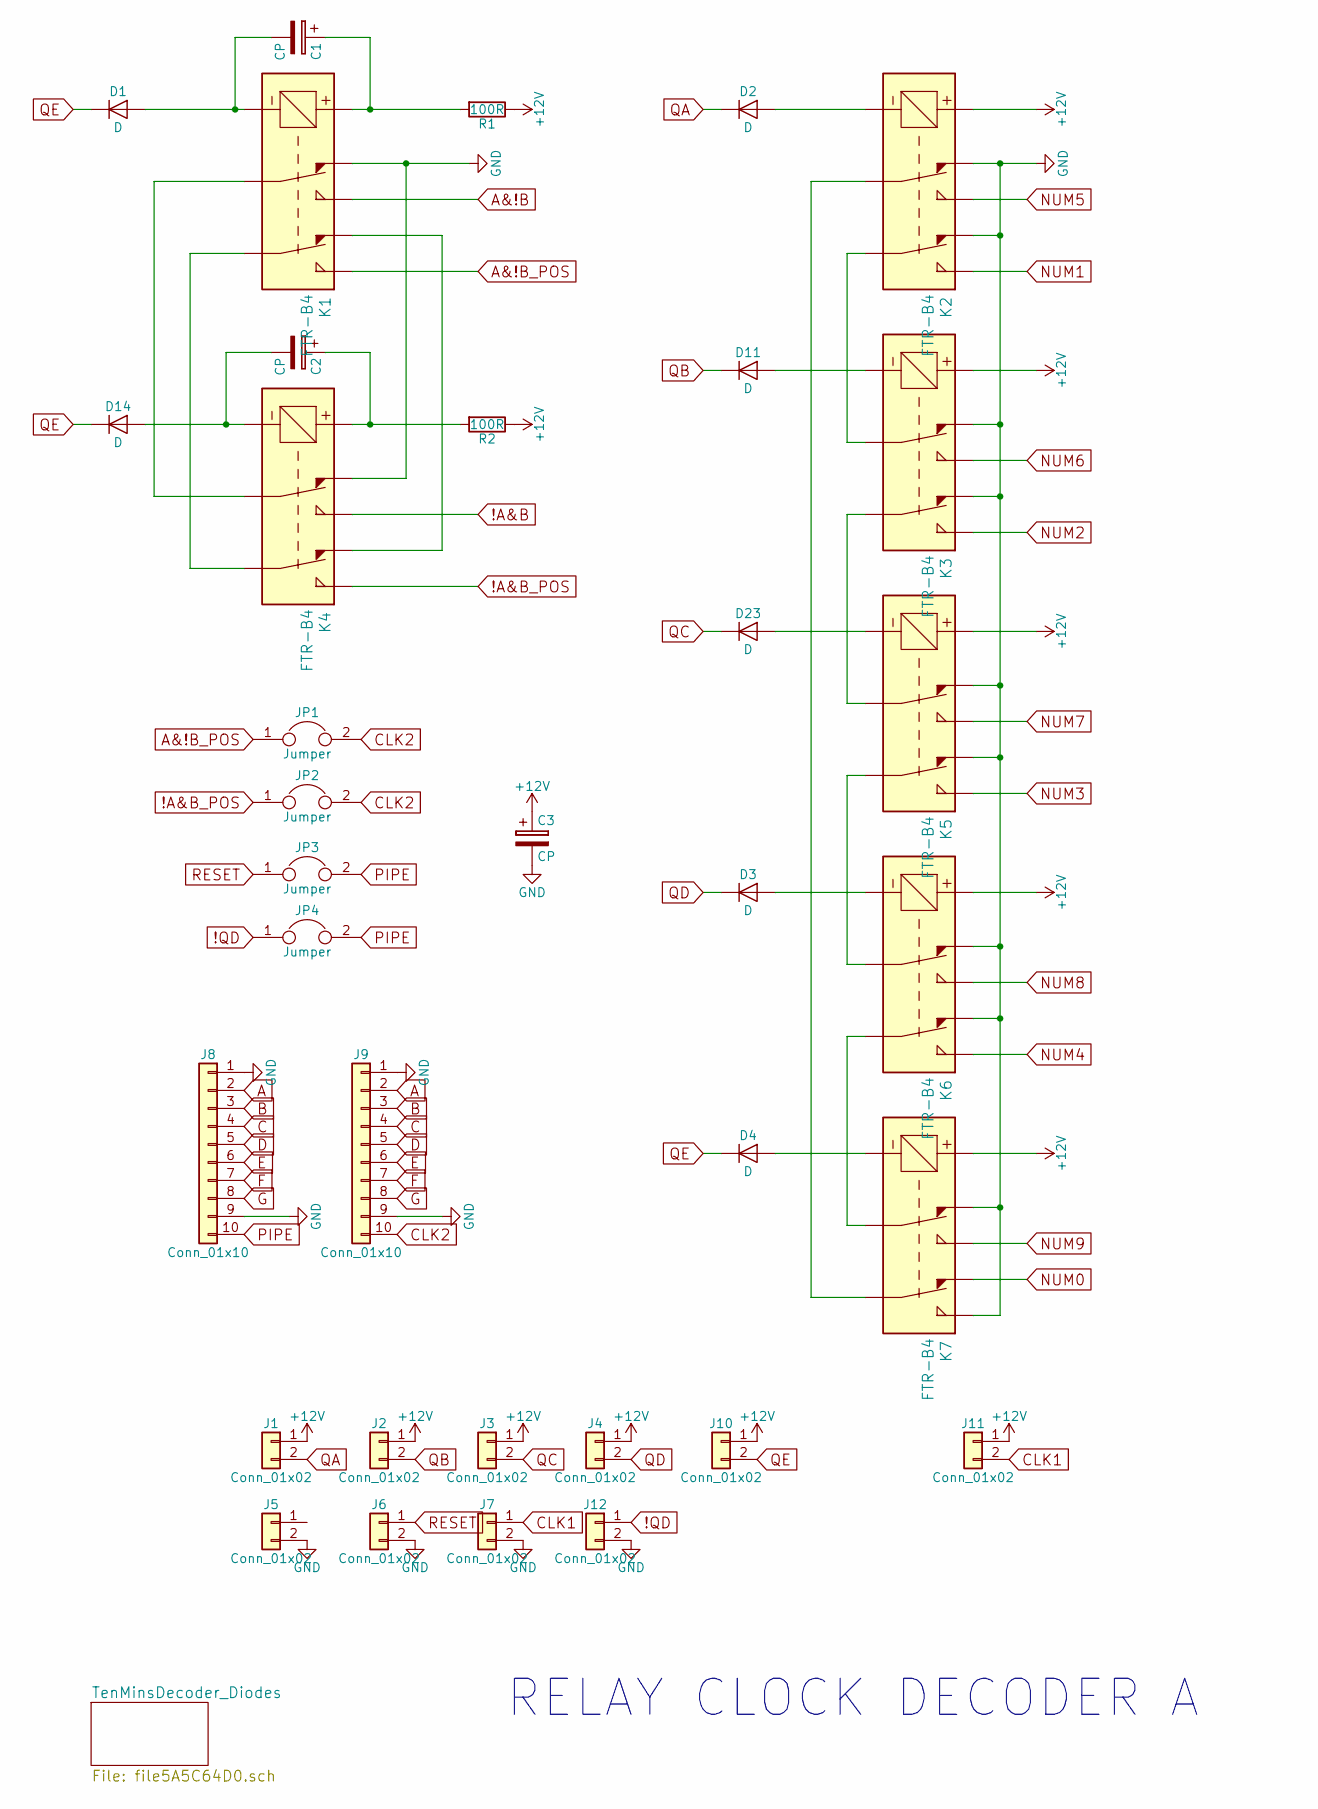
[picture p10: schematic DecoderA.sch]

Parts:
C1, C2: CP; C_Rect_L7.0mm_W3.5mm_P2.50mm_P5.00mm
C3: CP; CP_Radial_D6.3mm_P2.50mm_W11.00mm_vertical
D1, D2, D3, D4, D11, D14, D23: D; D_DO-41_SOD81_P7.62mm_Horizontal
J1, J2, J3, J4, J5, J6, J7, J10, J11, J12: Conn_01x02; PinHeader_1x02_P2.54mm_Vertical
J8, J9: Conn_01x10; PinHeader_1x10_P2.54mm_Vertical
JP1, JP2, JP3, JP4: Jumper; SolderJumper_01x02
K1, K2, K3, K4, K5, K6, K7: FTR-B4; FTR-B4_PTH
R1, R2: 100R; R_Axial_DIN0207_L6.3mm_D2.5mm_P10.16mm_Horizontal

Connections:
!A&B_POS: JP2.1, K4.4 (B3)
!QD: J12.1, JP4.1
+12V: C3.1, J1.1, J2.1, J3.1, J4.1, J10.1, J11.1, K2.1 (+), K3.1 (+), K5.1 (+), K6.1 (+), K7.1 (+), R1.1, R2.1
A: J8.2, J9.2; also elsewhere on the board
A&!B_POS: JP1.1, K1.4 (B3)
B: J8.3, J9.3; also elsewhere on the board
C: J8.4, J9.4; also elsewhere on the board
CLK1: J7.1, J11.2
CLK2: J9.10, JP1.2, JP2.2
D: J8.5, J9.5; also elsewhere on the board
E: J8.6, J9.6; also elsewhere on the board
F: J8.7, J9.7; also elsewhere on the board
G: J8.8, J9.8; also elsewhere on the board
GND: C3.2, J5.2, J6.2, J7.2, J8.1, J8.9, J9.1, J9.9, J12.2, K1.7 (A1), K2.2 (B1), K2.7 (A1), K3.2 (B1), K3.7 (A1), K4.7 (A1), K5.2 (B1), K5.7 (A1), K6.2 (B1), K6.7 (A1), K7.4 (B3), K7.7 (A1)
NUM0: K7.2 (B1); also elsewhere on the board
NUM1: K2.4 (B3); also elsewhere on the board
NUM2: K3.4 (B3); also elsewhere on the board
NUM3: K5.4 (B3); also elsewhere on the board
NUM4: K6.4 (B3); also elsewhere on the board
NUM5: K2.5 (A3); also elsewhere on the board
NUM6: K3.5 (A3); also elsewhere on the board
NUM7: K5.5 (A3); also elsewhere on the board
NUM8: K6.5 (A3); also elsewhere on the board
NUM9: K7.5 (A3); also elsewhere on the board
unnamed: C1.1, K1.1 (+), R1.2
unnamed: C1.2, D1.2 (A), K1.8 (-)
unnamed: C2.1, K4.1 (+), R2.2
unnamed: C2.2, D14.2 (A), K4.8 (-)
unnamed: D2.2 (A), K2.8 (-)
unnamed: D3.2 (A), K6.8 (-)
unnamed: D4.2 (A), K7.8 (-)
unnamed: D11.2 (A), K3.8 (-)
unnamed: D23.2 (A), K5.8 (-)
unnamed: K1.2 (B1), K4.2 (B1)
unnamed: K1.3 (B2), K4.3 (B2)
unnamed: K1.6 (A2), K4.6 (A2)
unnamed: K2.3 (B2), K3.6 (A2)
unnamed: K2.6 (A2), K7.3 (B2)
unnamed: K3.3 (B2), K5.6 (A2)
unnamed: K5.3 (B2), K6.6 (A2)
unnamed: K6.3 (B2), K7.6 (A2)
PIPE: J8.10, JP3.2, JP4.2
QA: D2.1 (K), J1.2
QB: D11.1 (K), J2.2
QC: D23.1 (K), J3.2
QD: D3.1 (K), J4.2
QE: D1.1 (K), D4.1 (K), D14.1 (K), J10.2
RESET: J6.1, JP3.1

Notes on the sheet:
RELAY CLOCK DECODER A

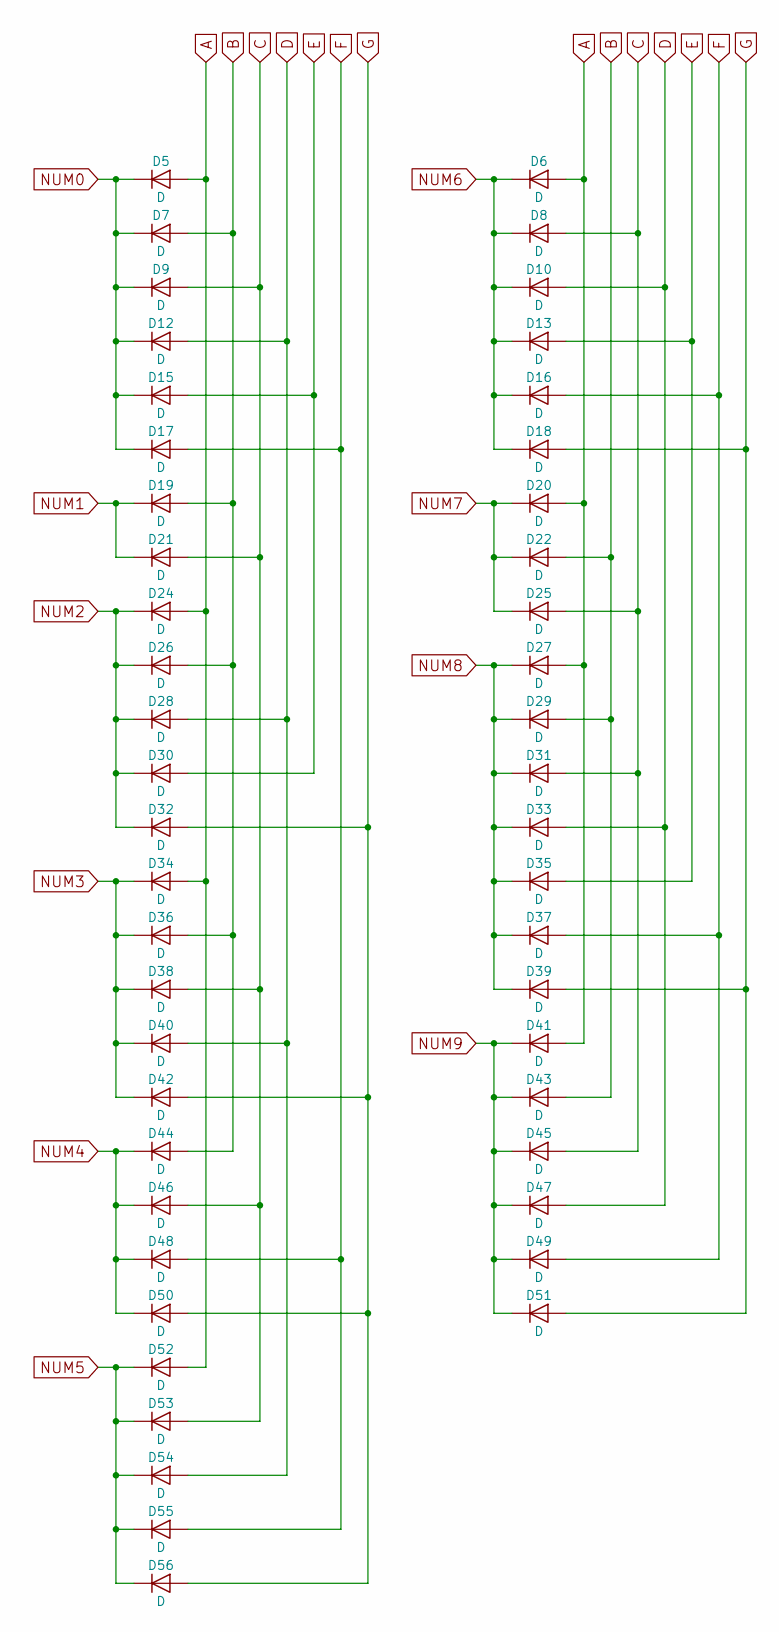
[picture p11: schematic file5A5C64D0.sch]

Parts:
D5, D6, D7, D8, D9, D10, D12, D13, D15, D16, D17, D18, D19, D20, D21, D22, D24, D25, D26, D27, D28, D29, D30, D31, D32, D33, D34, D35, D36, D37, D38, D39, D40, D41, D42, D43, D44, D45, D46, D47, D48, D49, D50, D51, D52, D53, D54, D55, D56: D; D_DO-41_SOD81_P7.62mm_Horizontal

Connections:
A: D5.2 (A), D6.2 (A), D20.2 (A), D24.2 (A), D27.2 (A), D34.2 (A), D41.2 (A), D52.2 (A); also elsewhere on the board
B: D7.2 (A), D19.2 (A), D22.2 (A), D26.2 (A), D29.2 (A), D36.2 (A), D43.2 (A), D44.2 (A); also elsewhere on the board
C: D8.2 (A), D9.2 (A), D21.2 (A), D25.2 (A), D31.2 (A), D38.2 (A), D45.2 (A), D46.2 (A), D53.2 (A); also elsewhere on the board
D: D10.2 (A), D12.2 (A), D28.2 (A), D33.2 (A), D40.2 (A), D47.2 (A), D54.2 (A); also elsewhere on the board
E: D13.2 (A), D15.2 (A), D30.2 (A), D35.2 (A); also elsewhere on the board
F: D16.2 (A), D17.2 (A), D37.2 (A), D48.2 (A), D49.2 (A), D55.2 (A); also elsewhere on the board
G: D18.2 (A), D32.2 (A), D39.2 (A), D42.2 (A), D50.2 (A), D51.2 (A), D56.2 (A); also elsewhere on the board
NUM0: D5.1 (K), D7.1 (K), D9.1 (K), D12.1 (K), D15.1 (K), D17.1 (K); also elsewhere on the board
NUM1: D19.1 (K), D21.1 (K); also elsewhere on the board
NUM2: D24.1 (K), D26.1 (K), D28.1 (K), D30.1 (K), D32.1 (K); also elsewhere on the board
NUM3: D34.1 (K), D36.1 (K), D38.1 (K), D40.1 (K), D42.1 (K); also elsewhere on the board
NUM4: D44.1 (K), D46.1 (K), D48.1 (K), D50.1 (K); also elsewhere on the board
NUM5: D52.1 (K), D53.1 (K), D54.1 (K), D55.1 (K), D56.1 (K); also elsewhere on the board
NUM6: D6.1 (K), D8.1 (K), D10.1 (K), D13.1 (K), D16.1 (K), D18.1 (K); also elsewhere on the board
NUM7: D20.1 (K), D22.1 (K), D25.1 (K); also elsewhere on the board
NUM8: D27.1 (K), D29.1 (K), D31.1 (K), D33.1 (K), D35.1 (K), D37.1 (K), D39.1 (K); also elsewhere on the board
NUM9: D41.1 (K), D43.1 (K), D45.1 (K), D47.1 (K), D49.1 (K), D51.1 (K); also elsewhere on the board

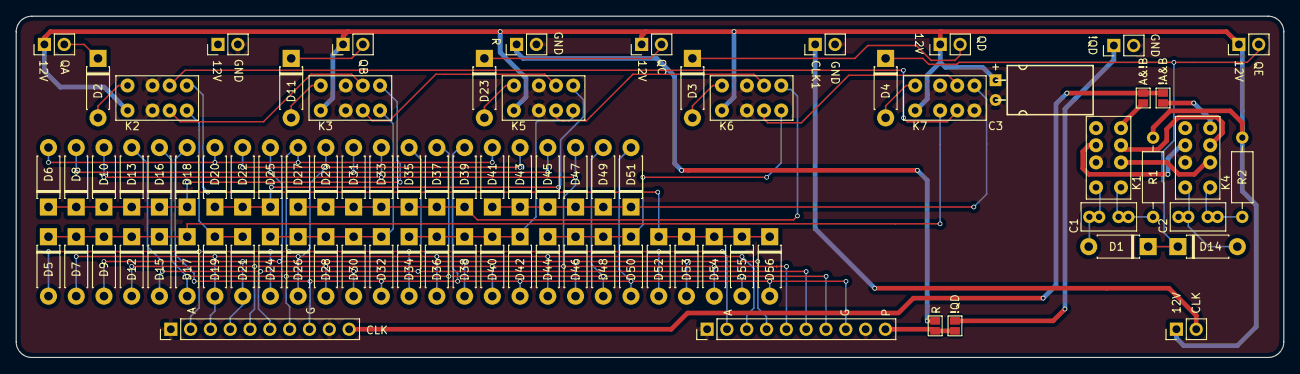
[picture p12: board DecoderA.kicad_pcb from above]

Board: 2 copper layers, 162.5 x 43.8 mm, 84 parts (0 on the bottom side), 48 nets.
