SwiftyTheFox001/RelayClock/kicad/FlipFlop/FlipFlop.kicad_pcb

## KiCad design kicad/FlipFlop/FlipFlop.kicad_pcb (2018-02-17)

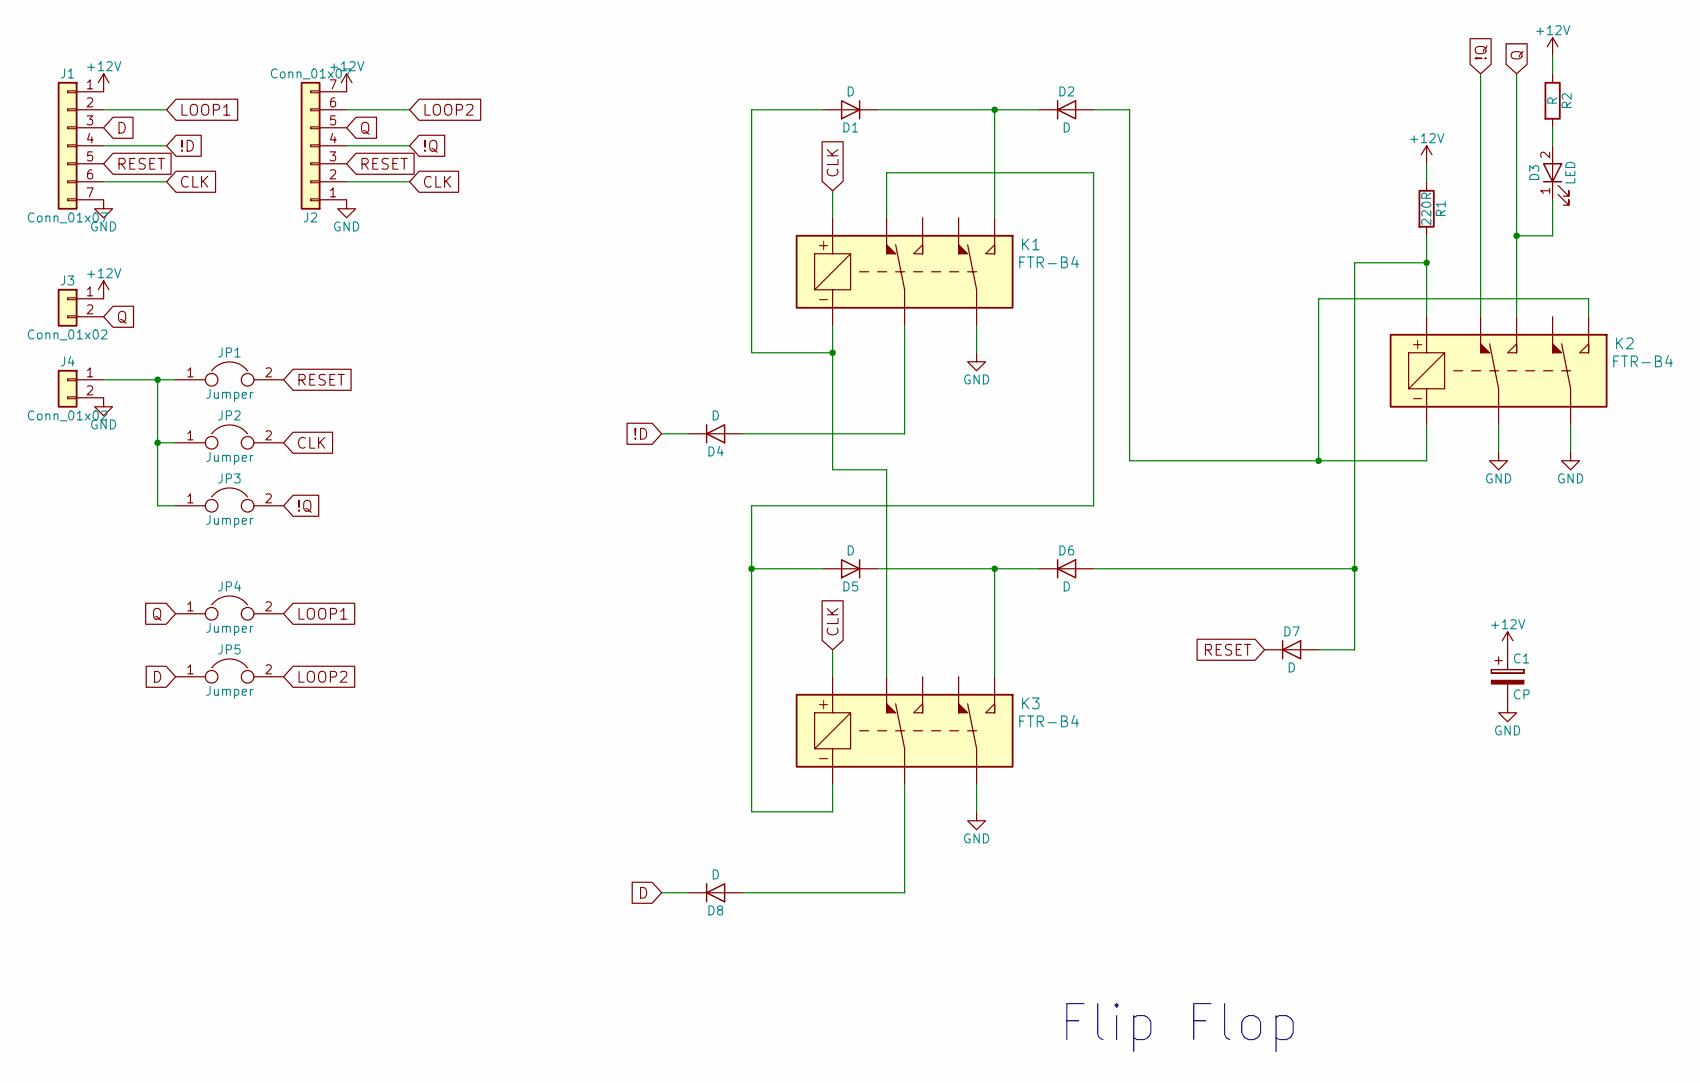
[picture p13: schematic FlipFlop.sch]

Parts:
C1: CP; CP_Radial_D6.3mm_P2.50mm_W11.00mm_vertical
D1, D2, D5, D6: D; D_DO-41_SOD81_P7.62mm_Horizontal
D3: LED; LED_0805_2012Metric_Pad0.97x1.50mm_HandSolder
D4, D7, D8: D; D_DO-41_SOD81_P2.54mm_Vertical_AnodeUp
J1, J2: Conn_01x07; PinHeader_1x07_P2.54mm_Vertical
J3, J4: Conn_01x02; PinHeader_1x02_P2.54mm_Vertical
JP1, JP2, JP3, JP4, JP5: Jumper; SolderJumper_01x02
K1, K2, K3: FTR-B4; FTR-B4_PTH
R1: 220R; R_Axial_DIN0207_L6.3mm_D2.5mm_P10.16mm_Horizontal
R2: R; R_Axial_DIN0207_L6.3mm_D2.5mm_P10.16mm_Horizontal

Connections:
!D: D4.1 (K), J1.4
!Q: J2.4, JP3.2, K2.7 (A1)
+12V: C1.1, J1.1, J2.7, J3.1, R1.1, R2.1
CLK: J1.6, J2.2, JP2.2, K1.1 (+), K3.1 (+)
D: D8.1 (K), J1.3, JP5.1
GND: C1.2, J1.7, J2.1, J4.2, K1.3 (B2), K2.3 (B2), K2.6 (A2), K3.3 (B2)
LOOP1: J1.2, JP4.2
LOOP2: J2.6, JP5.2
unnamed: D1.1 (K), D2.1 (K), K1.4 (B3)
unnamed: D1.2 (A), K1.8 (-), K3.7 (A1)
unnamed: D2.2 (A), K2.4 (B3), K2.8 (-)
unnamed: D3.2 (A), R2.2
unnamed: D4.2 (A), K1.6 (A2)
unnamed: D5.1 (K), D6.1 (K), K3.4 (B3)
unnamed: D5.2 (A), K1.7 (A1), K3.8 (-)
unnamed: D6.2 (A), D7.2 (A), K2.1 (+), R1.2
unnamed: D8.2 (A), K3.6 (A2)
unnamed: J4.1, JP1.1, JP2.1, JP3.1
Q: D3.1 (K), J2.5, J3.2, JP4.1, K2.5 (A3)
RESET: D7.1 (K), J1.5, J2.3, JP1.2

Notes on the sheet:
Flip Flop

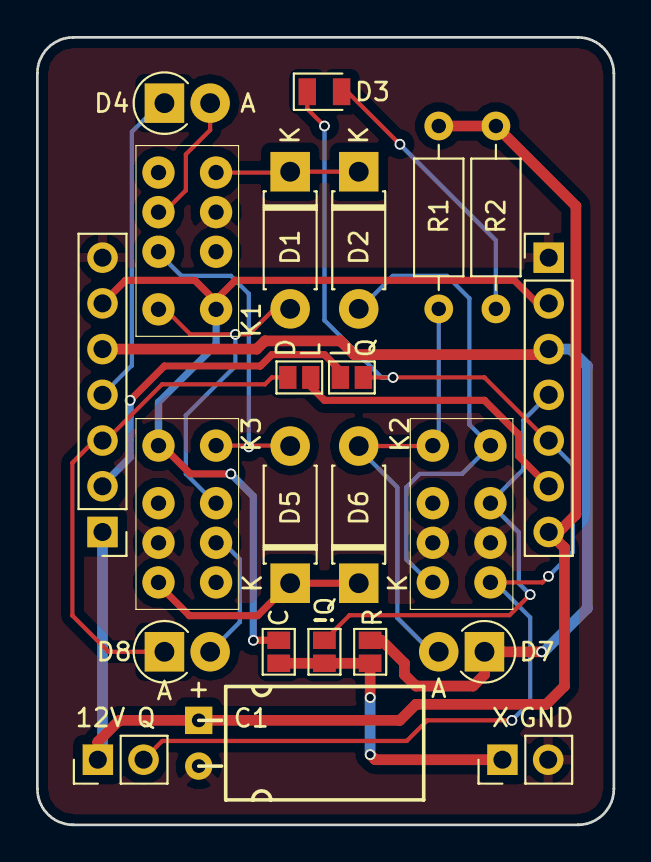
[picture p14: board FlipFlop.kicad_pcb from above]

Board: 2 copper layers, 32.0 x 43.8 mm, 23 parts (0 on the bottom side), 20 nets.
