SwiftyTheFox001/RelayClock/kicad/DecoderB/DecoderB.kicad_pcb

## KiCad design kicad/DecoderB/DecoderB.kicad_pcb (2018-02-17)

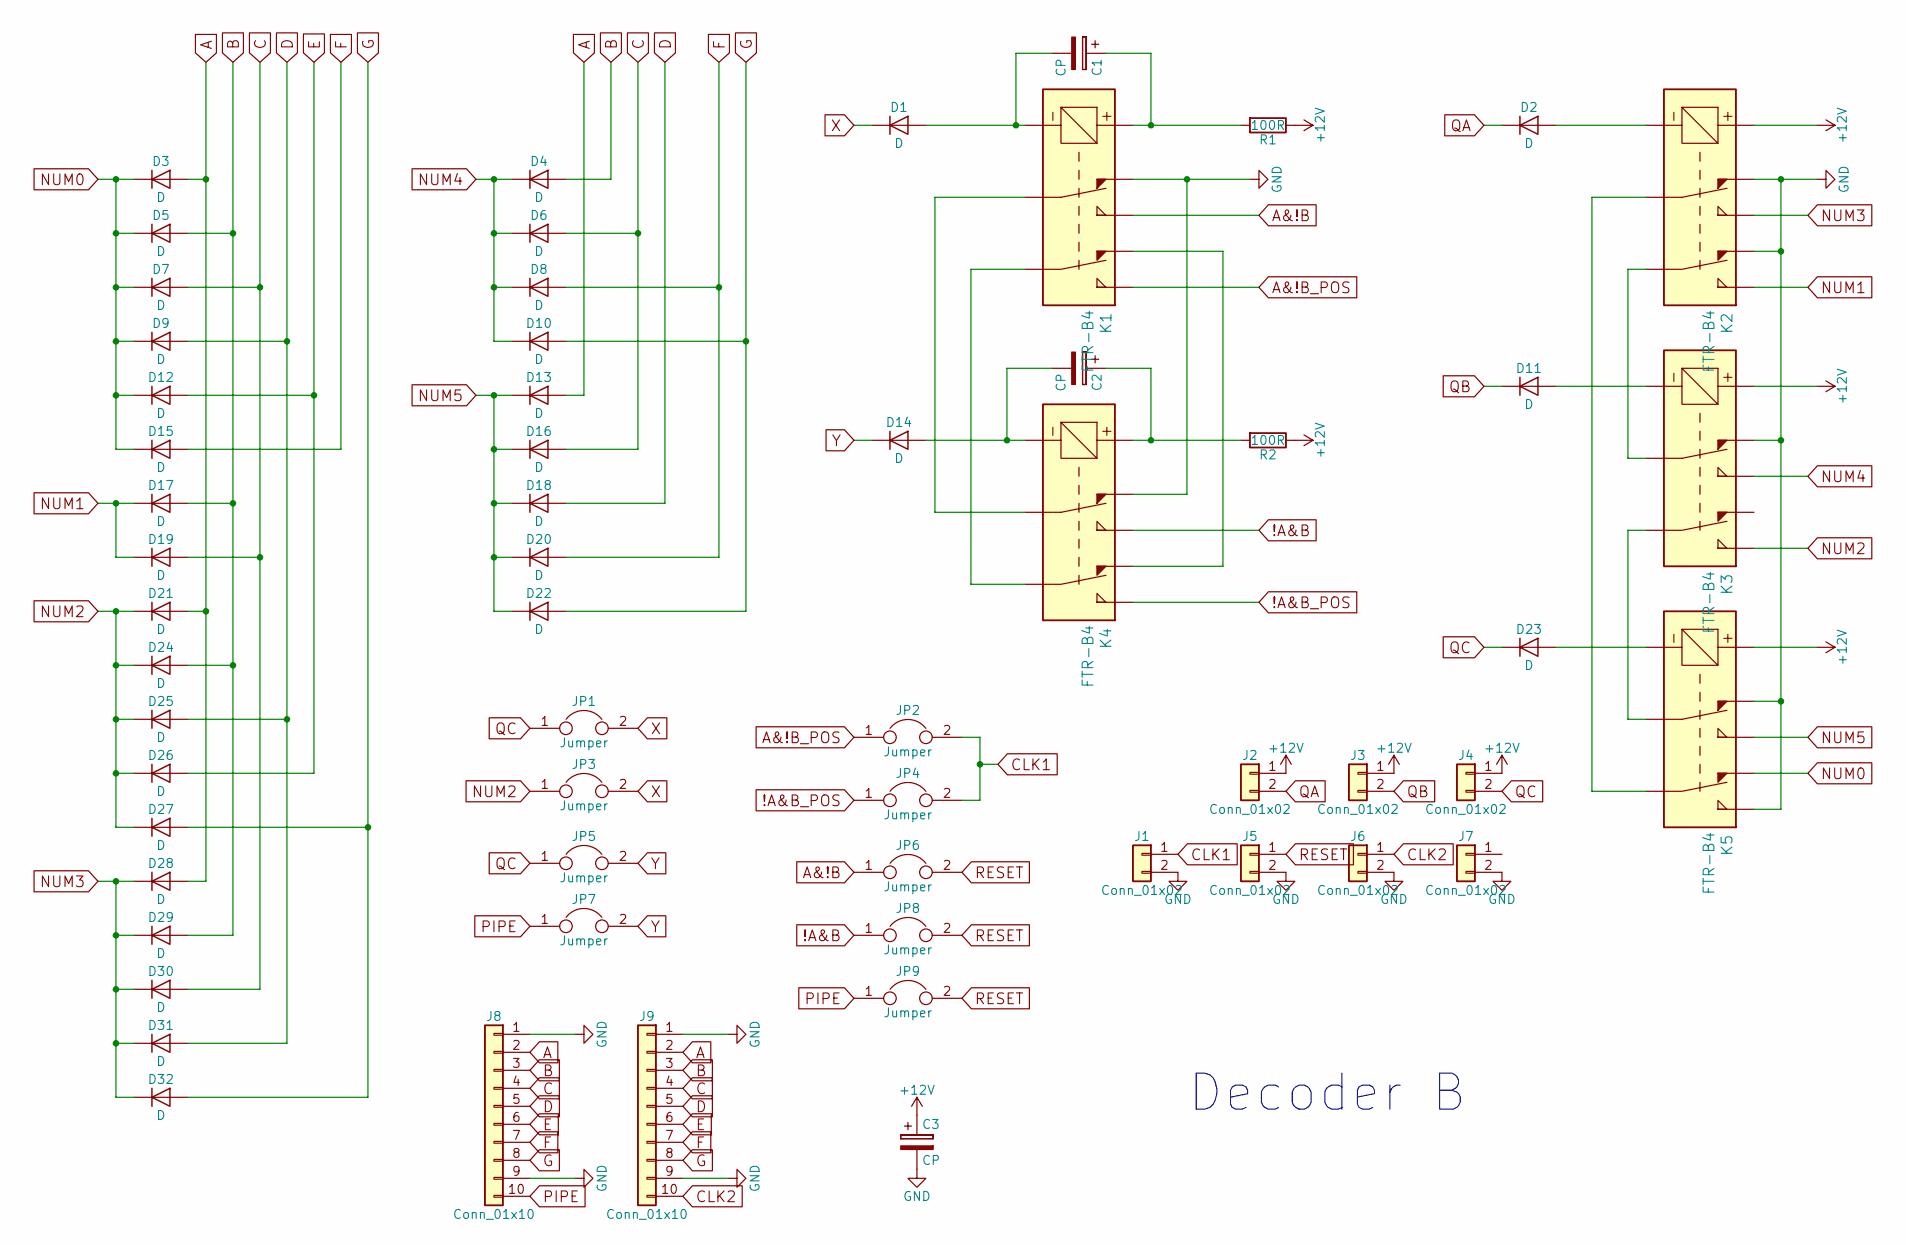
[picture p15: schematic DecoderB.sch, Decoder B]

Parts:
C1, C2: CP; C_Rect_L7.0mm_W3.5mm_P2.50mm_P5.00mm
C3: CP; CP_Radial_D6.3mm_P2.50mm_W11.00mm_vertical
D1, D2, D3, D4, D5, D6, D7, D8, D9, D10, D11, D12, D13, D14, D15, D16, D17, D18, D19, D20, D21, D22, D23, D24, D25, D26, D27, D28, D29, D30, D31, D32: D; D_DO-41_SOD81_P7.62mm_Horizontal
J1, J2, J3, J4, J5, J6, J7: Conn_01x02; PinHeader_1x02_P2.54mm_Vertical
J8, J9: Conn_01x10; PinHeader_1x10_P2.54mm_Vertical
JP1, JP2, JP3, JP4, JP5, JP6, JP7, JP8, JP9: Jumper; SolderJumper_01x02
K1, K2, K3, K4, K5: FTR-B4; FTR-B4_PTH
R1, R2: 100R; R_Axial_DIN0207_L6.3mm_D2.5mm_P10.16mm_Horizontal

Connections:
!A&B: JP8.1, K4.5 (A3)
!A&B_POS: JP4.1, K4.4 (B3)
+12V: C3.1, J2.1, J3.1, J4.1, K2.1 (+), K3.1 (+), K5.1 (+), R1.1, R2.1
A: D3.2 (A), D13.2 (A), D21.2 (A), D28.2 (A), J8.2, J9.2
A&!B: JP6.1, K1.5 (A3)
A&!B_POS: JP2.1, K1.4 (B3)
B: D4.2 (A), D5.2 (A), D17.2 (A), D24.2 (A), D29.2 (A), J8.3, J9.3
C: D6.2 (A), D7.2 (A), D16.2 (A), D19.2 (A), D30.2 (A), J8.4, J9.4
CLK1: J1.1, JP2.2, JP4.2
CLK2: J6.1, J9.10
D: D9.2 (A), D18.2 (A), D25.2 (A), D31.2 (A), J8.5, J9.5
E: D12.2 (A), D26.2 (A), J8.6, J9.6
F: D8.2 (A), D15.2 (A), D20.2 (A), J8.7, J9.7
G: D10.2 (A), D22.2 (A), D27.2 (A), D32.2 (A), J8.8, J9.8
GND: C3.2, J1.2, J5.2, J6.2, J7.2, J8.1, J8.9, J9.1, J9.9, K1.7 (A1), K2.2 (B1), K2.7 (A1), K3.7 (A1), K4.7 (A1), K5.4 (B3), K5.7 (A1)
NUM0: D3.1 (K), D5.1 (K), D7.1 (K), D9.1 (K), D12.1 (K), D15.1 (K), K5.2 (B1)
NUM1: D17.1 (K), D19.1 (K), K2.4 (B3)
NUM2: D21.1 (K), D24.1 (K), D25.1 (K), D26.1 (K), D27.1 (K), JP3.1, K3.4 (B3)
NUM3: D28.1 (K), D29.1 (K), D30.1 (K), D31.1 (K), D32.1 (K), K2.5 (A3)
NUM4: D4.1 (K), D6.1 (K), D8.1 (K), D10.1 (K), K3.5 (A3)
NUM5: D13.1 (K), D16.1 (K), D18.1 (K), D20.1 (K), D22.1 (K), K5.5 (A3)
unnamed: C1.1, K1.1 (+), R1.2
unnamed: C1.2, D1.2 (A), K1.8 (-)
unnamed: C2.1, K4.1 (+), R2.2
unnamed: C2.2, D14.2 (A), K4.8 (-)
unnamed: D2.2 (A), K2.8 (-)
unnamed: D11.2 (A), K3.8 (-)
unnamed: D23.2 (A), K5.8 (-)
unnamed: K1.2 (B1), K4.2 (B1)
unnamed: K1.3 (B2), K4.3 (B2)
unnamed: K1.6 (A2), K4.6 (A2)
unnamed: K2.3 (B2), K3.6 (A2)
unnamed: K2.6 (A2), K5.3 (B2)
unnamed: K3.3 (B2), K5.6 (A2)
PIPE: J8.10, JP7.1, JP9.1
QA: D2.1 (K), J2.2
QB: D11.1 (K), J3.2
QC: D23.1 (K), J4.2, JP1.1, JP5.1
RESET: J5.1, JP6.2, JP8.2, JP9.2
X: D1.1 (K), JP1.2, JP3.2
Y: D14.1 (K), JP5.2, JP7.2

Notes on the sheet:
Decoder B
