SwiftyTheFox001/RelayClock/kicad/DecoderB/DecoderB.kicad_pcb

## KiCad design kicad/DecoderB/DecoderB.kicad_pcb (continued)

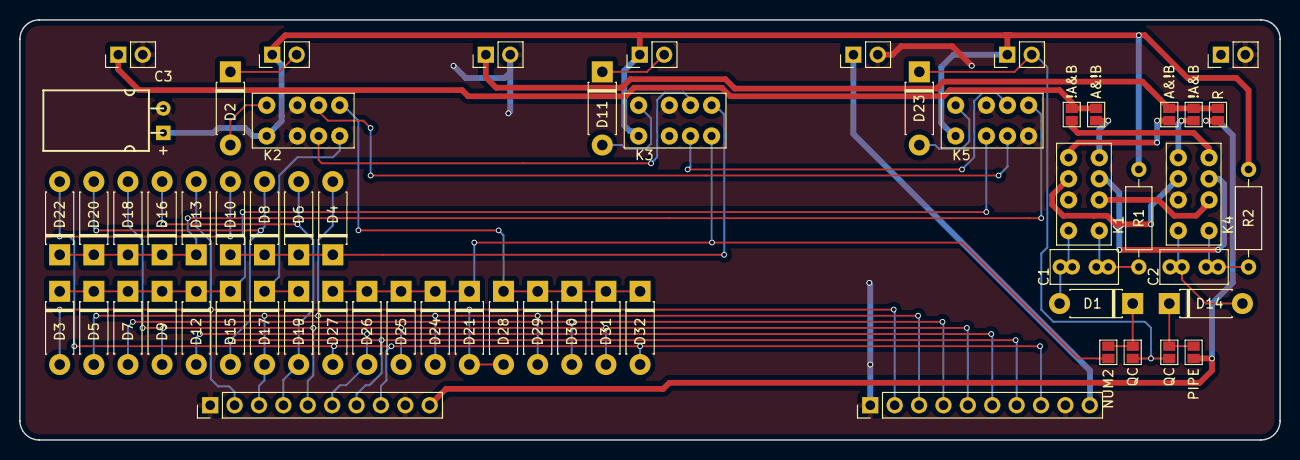
[picture p16: board DecoderB.kicad_pcb from above]

Board: 2 copper layers, 131.2 x 43.8 mm, 60 parts (0 on the bottom side), 41 nets.
